JHU-Delivery-Robot/electrical/PMS/PMS/PMS.kicad_pcb

## KiCad design PMS/PMS/PMS.kicad_pcb (2022-04-30)

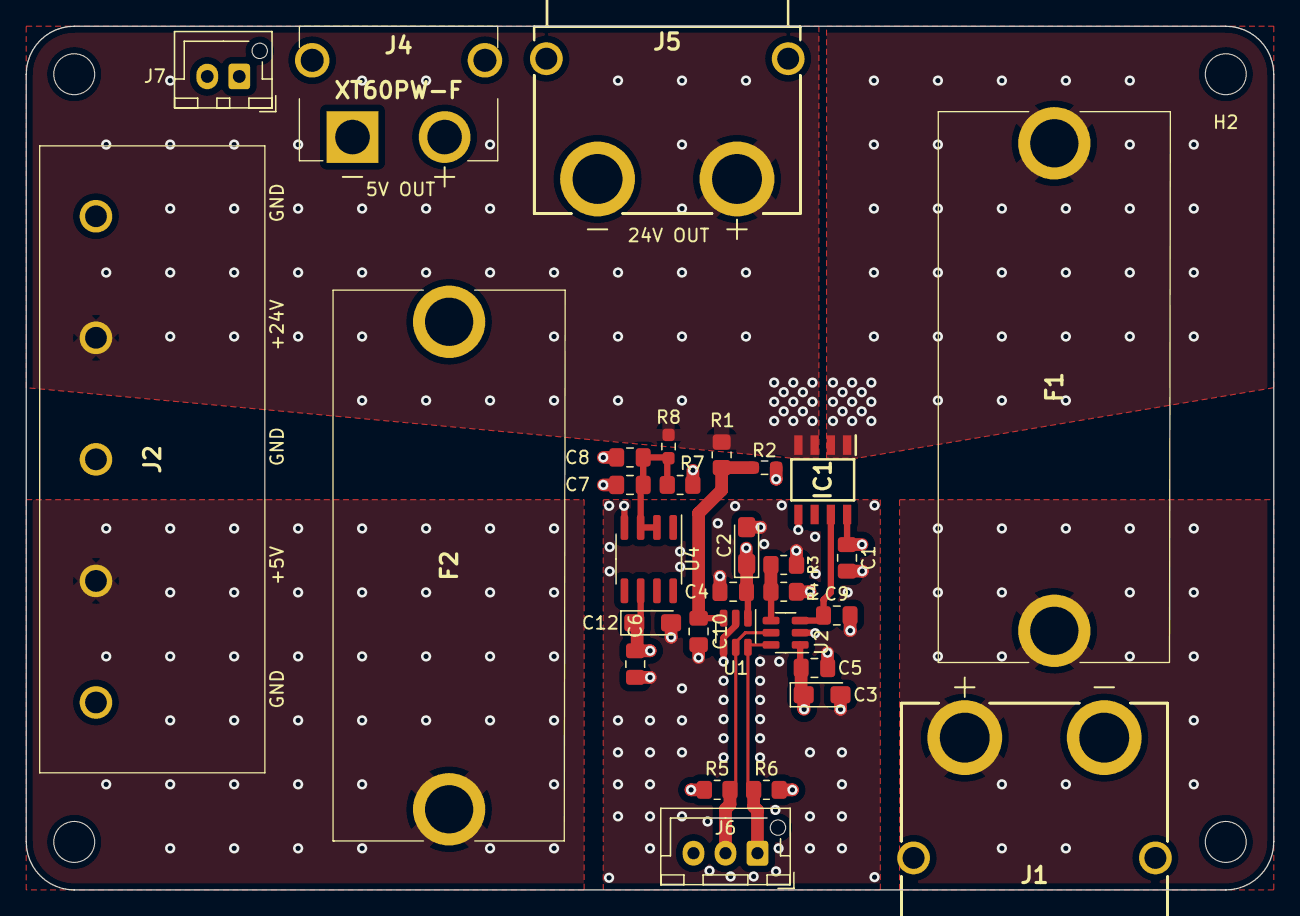
[picture p1: board PMS.kicad_pcb from above]

Board: 4 copper layers, 97.5 x 67.5 mm, 35 parts (0 on the bottom side), 13 nets.

Parts:
C1, C4, C5, C6, C7: .1uF; C_0805_2012Metric_Pad1.18x1.45mm_HandSolder
C2, C3: 4.7uF; CP_EIA-3216-18_Kemet-A_Pad1.58x1.35mm_HandSolder
C8: 10uF; C_0805_2012Metric_Pad1.18x1.45mm_HandSolder
C9, C10: 470 pF; C_0805_2012Metric_Pad1.18x1.45mm_HandSolder
C12: 1 uF; CP_EIA-3216-18_Kemet-A_Pad1.58x1.35mm_HandSolder
F1: 30A; 3576
F2: 7.5+ A; 3576
H1, H2, H3, H4: MountingHole; MountingHole_3.2mm_M3_ISO14580
IC1: TMCS1107A1BQDRQ1; SOIC127P600X175-8N
J1: XT90PW-M; XT90PWM
J2: OSTYK44105030
J4: XT60PW-F; XT60PWF
J5: XT90PW-F
J6: Conn_01x03_Male; JST_XH_B3B-XH-AM_1x03_P2.50mm_Vertical
J7: Conn_01x02_Male; JST_XH_B2B-XH-AM_1x02_P2.50mm_Vertical
R1: 100K; R_0805_2012Metric_Pad1.20x1.40mm_HandSolder
R2: 20K; R_0603_1608Metric_Pad0.98x0.95mm_HandSolder
R3, R4: 1M; R_0805_2012Metric_Pad1.20x1.40mm_HandSolder
R5, R6: 10K; R_0805_2012Metric_Pad1.20x1.40mm_HandSolder
R7: 1.5K; R_0805_2012Metric_Pad1.20x1.40mm_HandSolder
R8: 1.5K; R_0603_1608Metric_Pad0.98x0.95mm_HandSolder
U1, U2: ADC101C027CIMK; SOT-23-6
U4: REF195; SOIC-8_3.9x4.9mm_P1.27mm

Connections:
24V_OUT: IC1.3 (IN-_1), IC1.4 (IN-_2), J2.2, J5.2 (+), R1.1, R8.2
+5V: F2.2, J4.2 (+), J7.2
+5VA: C1.1, C2.1, C3.1, C4.1, C5.1, C6.1, C12.1, IC1.8 (VS), R4.2, R5.2, R6.2, U1.1 (V_{A}), U2.1 (V_{A}), U4.6 (Vout)
+5VP: F2.1, J2.4
+24V: F1.2, IC1.1 (IN+_1), IC1.2 (IN+_2)
+BATT: F1.1, J1.2 (+)
GND: C1.2, C2.2, C3.2, C4.2, C5.2, C6.2, C7.1, C8.2, C9.2, C10.2, C12.2, IC1.5 (GND), J1.1 (-), J2.1, J2.3, J2.5, J4.1 (-), J4.3, J4.4, J5.1 (-), J7.1, R2.2, R3.2, R7.1, U1.2 (GND), U1.4 (ADDR), U2.2 (GND), U4.4 (GND)
unnamed: C7.2, C8.1, R7.2, R8.1, U4.2 (Vin), U4.3 (~Sleep)
unnamed: C9.1, IC1.7 (VOUT), U2.3 (V_{IN})
unnamed: C10.1, R1.2, R2.1, U1.3 (V_{IN})
unnamed: R3.1, R4.1, U2.4 (ADDR)
SCL: J6.2, R5.1, U1.5 (SCL), U2.5 (SCL)
SDA: J6.1, R6.1, U1.6 (SDA), U2.6 (SDA)
