JHU-Delivery-Robot/electrical/IR-Breakout/IR-Breakout.kicad_pcb

## KiCad design IR-Breakout/IR-Breakout.kicad_pcb (2022-04-19)

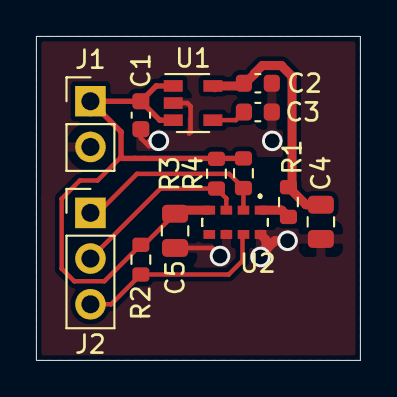
[picture p2: board IR-Breakout.kicad_pcb from above]

Board: 2 copper layers, 18.0 x 18.0 mm, 13 parts (0 on the bottom side), 8 nets.

Parts:
C1, C2: 1u; C_0603_1608Metric
C3: 0.1u; C_0603_1608Metric
C4: 4.7u; C_0805_2012Metric
C5: 10u; C_0805_2012Metric
J1: PWR; PinHeader_1x02_P2.54mm_Vertical
J2: I2C; PinHeader_1x03_P2.54mm_Vertical
R1: 22; R_0603_1608Metric
R2, R3, R4: 10K; R_0603_1608Metric
U1: LDK120M18R; SOT-23-5
U2: TMD37253M

Connections:
+1V8: C2.1, C4.1, R1.1, U1.5 (OUT)
+3V3: C1.1, C5.1, J1.1, R2.1, R3.1, R4.1, U1.1 (IN), U1.3 (EN), U2.4 (LEDA)
/INT: J2.3, R2.2, U2.7 (INT)
/SCL: J2.2, R3.2, U2.3 (SCL)
/SDA: J2.1, R4.2, U2.2 (SDA)
GND: C1.2, C2.2, C3.2, C4.2, C5.2, J1.2, U1.2 (GND), U2.6 (PGND), U2.8 (VSS)
unnamed: C3.1, U1.4 (BP)
unnamed: R1.2, U2.1 (VDD)
