JHU-Delivery-Robot/electrical/motor-controller/motor-controller.kicad_pcb

## KiCad design motor-controller/motor-controller.kicad_pcb (2021-01-12)

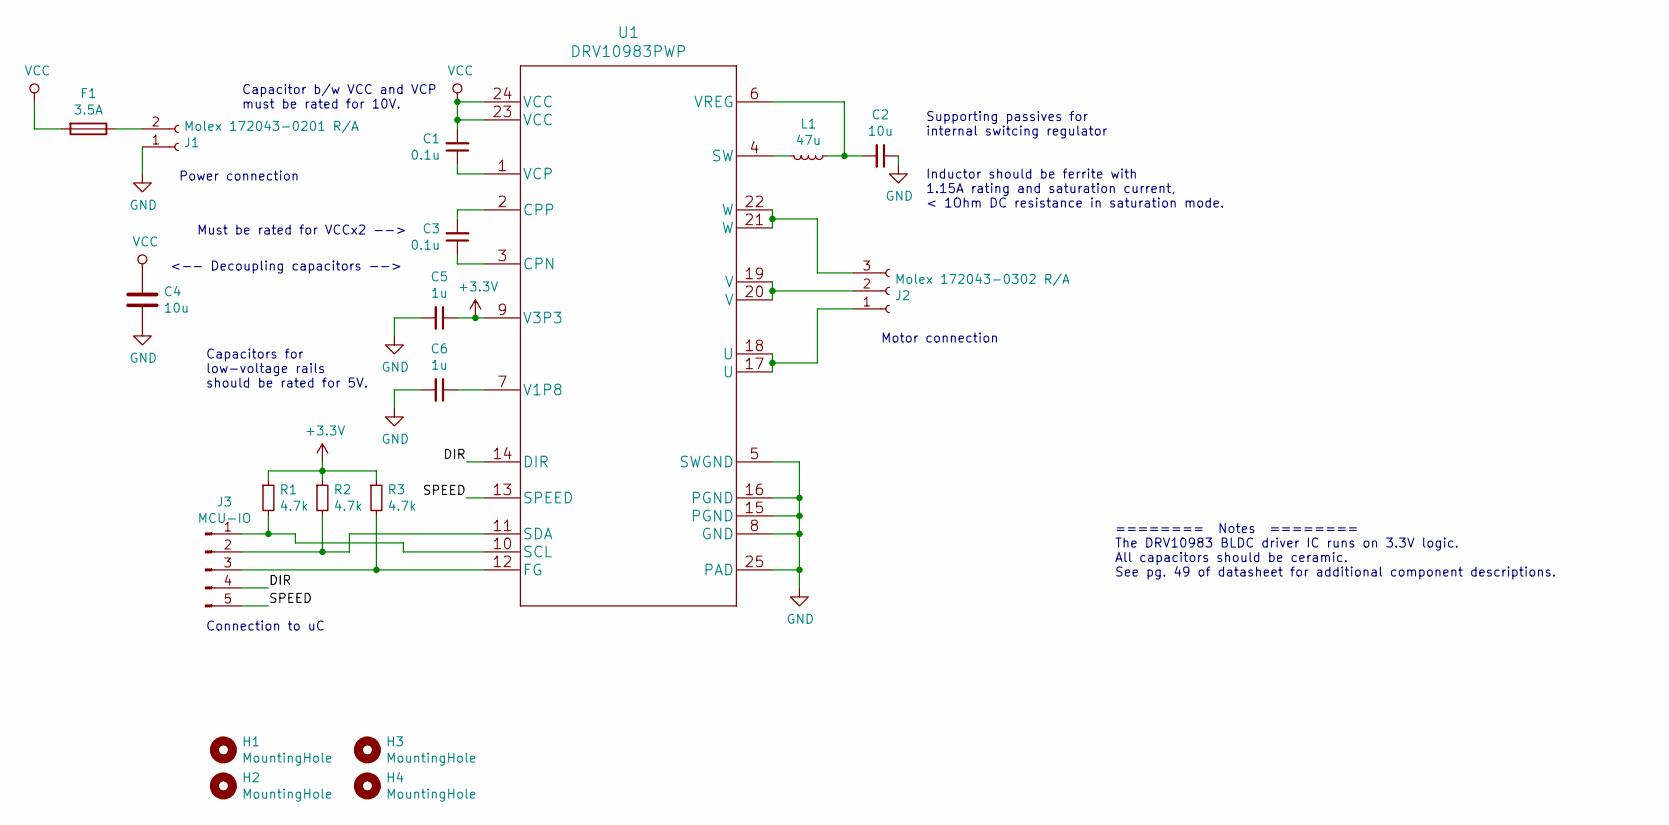
[picture p3: schematic motor-controller.sch, Brushless DC Motor Controller]

Parts:
C1, C3: 0.1u; C_0603_1608Metric
C2, C4: 10u; C_0603_1608Metric
C5, C6: 1u; C_0603_1608Metric
F1: 3.5A; littelfuse-01110505Z-5x15mm
H1, H2, H3, H4: MountingHole; MountingHole_3.2mm_M3
J1: Molex 172043-0201 R/A; CONN_1720430201_MOL
J2: Molex 172043-0302 R/A; 172043-0302_MOL
J3: MCU-IO; JST_XH_B05B-XH-AM_1x05_P2.50mm_Vertical
L1: 47u; L_Taiyo-Yuden_NR-60xx
R1, R2, R3: 4.7k; R_0603_1608Metric
U1: DRV10983PWP; PWP0024B

Connections:
+3V3: C5.1, R1.1, R2.1, R3.1, U1.9 (V3P3); also elsewhere on the board
/DIR: J3.4, U1.14 (DIR); also elsewhere on the board
/SPEED: J3.5, U1.13 (SPEED); also elsewhere on the board
GND: C2.1, C4.2, C5.2, C6.2, J1.1, U1.5 (SWGND), U1.8 (GND), U1.15 (PGND), U1.16 (PGND), U1.25 (PAD); also elsewhere on the board
unnamed 4: C1.1, U1.1 (VCP); also elsewhere on the board
unnamed 5: C2.2, L1.1, U1.6 (VREG); also elsewhere on the board
unnamed 6: C3.1, U1.3 (CPN); also elsewhere on the board
unnamed 7: C3.2, U1.2 (CPP); also elsewhere on the board
unnamed 8: C6.1, U1.7 (V1P8); also elsewhere on the board
unnamed: F1.1, J1.2
unnamed 10: J2.1, U1.17 (U), U1.18 (U); also elsewhere on the board
unnamed 11: J2.2, U1.19 (V), U1.20 (V); also elsewhere on the board
unnamed 12: J2.3, U1.21 (W), U1.22 (W); also elsewhere on the board
unnamed 13: J3.1, R1.2, U1.10 (SCL); also elsewhere on the board
unnamed 14: J3.2, R2.2, U1.11 (SDA); also elsewhere on the board
unnamed 15: J3.3, R3.2, U1.12 (FG); also elsewhere on the board
unnamed 16: L1.2, U1.4 (SW); also elsewhere on the board
VCC: C1.2, C4.1, F1.2, U1.23 (VCC), U1.24 (VCC); also elsewhere on the board

Notes on the sheet:
Motor connection
Power connection
<-- Decoupling capacitors -->
Supporting passives for internal switcing regulator
Connection to uC
Capacitor b/w VCC and VCP must be rated for 10V.
Capacitors for low-voltage rails should be rated for 5V.
Must be rated for VCCx2 -->
======== Notes ======== The DRV10983 BLDC driver IC runs on 3.3V logic. All capacitors should be ceramic. See pg. 49 of datasheet for additional component descriptions.
Inductor should be ferrite with 1.15A rating and saturation current, < 1Ohm DC resistance in saturation mode.

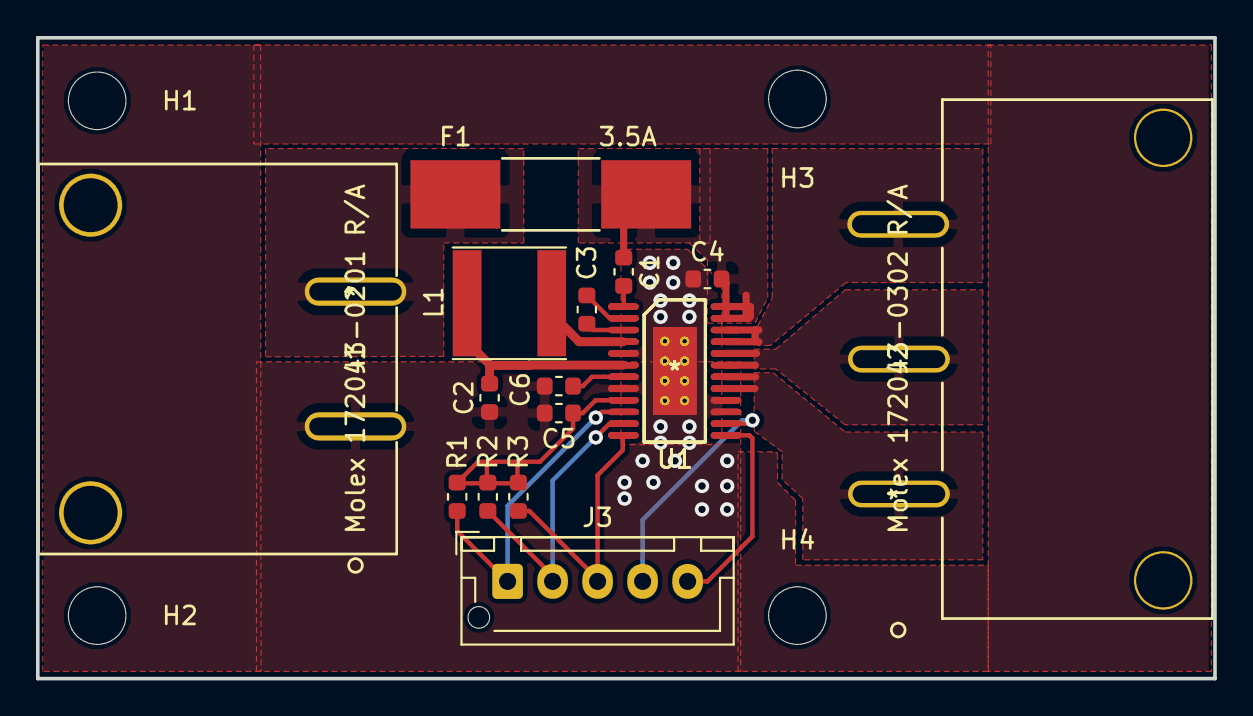
[picture p4: board motor-controller.kicad_pcb from above]

Board: 2 copper layers, 65.4 x 35.6 mm, 21 parts (0 on the bottom side), 18 nets.

Other parts of the board:
U1#2, U1#3: DRV10983PWP; PWP0024B

Their connections:
+3V3: U1#2.9, U1#3.9; also elsewhere on the board
/DIR: U1#2.14, U1#3.14; also elsewhere on the board
/SPEED: U1#2.13, U1#3.13; also elsewhere on the board
GND: U1#2.5, U1#2.8, U1#2.15, U1#2.16, U1#2.25, U1#3.5, U1#3.8, U1#3.15, U1#3.16, U1#3.25; also elsewhere on the board
unnamed 4: U1#2.1, U1#3.1; also elsewhere on the board
unnamed 5: U1#2.6, U1#3.6; also elsewhere on the board
unnamed 6: U1#2.3, U1#3.3; also elsewhere on the board
unnamed 7: U1#2.2, U1#3.2; also elsewhere on the board
unnamed 8: U1#2.7, U1#3.7; also elsewhere on the board
unnamed 10: U1#2.17, U1#2.18, U1#3.17, U1#3.18; also elsewhere on the board
unnamed 11: U1#2.19, U1#2.20, U1#3.19, U1#3.20; also elsewhere on the board
unnamed 12: U1#2.21, U1#2.22, U1#3.21, U1#3.22; also elsewhere on the board
unnamed 13: U1#2.10, U1#3.10; also elsewhere on the board
unnamed 14: U1#2.11, U1#3.11; also elsewhere on the board
unnamed 15: U1#2.12, U1#3.12; also elsewhere on the board
unnamed 16: U1#2.4, U1#3.4; also elsewhere on the board
VCC: U1#2.23, U1#2.24, U1#3.23, U1#3.24; also elsewhere on the board
