JHU-Delivery-Robot/electrical/(commit log)

2020-12-30 Added BLDC motorcontroller IC PCB
    [motor-controller.kicad_pcb, motor-controller.sch]
2020-12-30 Added ground planes, thermal vias
    [motor-controller.kicad_pcb]
2020-12-30 Added back top edge cut
    [motor-controller.kicad_pcb]
2021-01-12 Added fuse holder and modified position of mounting holes
    [motor-controller.kicad_pcb, motor-controller.sch]
2021-09-12 Add IR Breakout PCB
    Note: This PCB is designed to be fabricated on the PCB mill.
    [IR-Breakout.csv, IR-Breakout.kicad_pcb, IR-Breakout.sch]
2022-02-15 Adding PMS. Pending review
    [PMS.kicad_pcb, PMS.kicad_sch]
2022-02-15 several changes to satisfy ERC
    [PMS.kicad_sch]
2022-02-23 Updated PMS. Now includes option for LA12 with other fixes.
    [PMS.kicad_sch]
2022-02-24 annotated schematic
    [PMS.kicad_sch]
2022-02-25 added reverse polarity protection
    [PMS.kicad_sch]
2022-02-25 cleanup and now ERC compliant
    [PMS.kicad_sch]
2022-02-25 switched to the correct zener diode
    [PMS.kicad_sch]
2022-03-03 Associated footprints to components
    [PMS.kicad_sch]
2022-03-06 adding BOM PMS.csv
    [PMS.csv, PMS.kicad_pcb, PMS.kicad_sch]
2022-03-07 Layout complete.
    [PMS.kicad_pcb, PMS.kicad_sch]
2022-03-07 all traces now routed on the topmost layer
    [PMS.kicad_pcb]
2022-03-08 moved silkscreen
    [PMS.kicad_pcb]
2022-03-15 Changed regulator and updated layout. No longer includes LA12.
    [PMS.kicad_pcb]
2022-03-15 updates to satisfy DRC
    [PMS.kicad_pcb]
2022-03-16 changed solder jumper footprint and added silk labels for XT60 connectors
    [PMS.kicad_pcb, PMS.kicad_sch]
2022-03-18 changed to XT90s for 24V
    [PMS.kicad_pcb, PMS.kicad_sch]
2022-03-20 Changed to barrier strip for connection to Mean-Well. Interconnects cannot be erroneously connected
    [PMS.kicad_pcb, PMS.kicad_sch]
2022-03-23 Adding updated BOM
    [PMS.csv]
2022-04-11 updated PMS. Resistor values chosen for accurate current. ADC layouts altered to add via fence and reduce EMI. ADC input low-pass capacitors added.
    [PMS.kicad_pcb, PMS.kicad_sch]
2022-04-12 minor changes
    [PMS.kicad_pcb, PMS.kicad_sch]
2022-04-12 changed star ground
    [PMS.kicad_pcb]
2022-04-12 More changes to grounding
    [PMS.kicad_pcb]
2022-04-19 corrected values for pullups on SDA, SCL, and INT
    [IR-Breakout.kicad_pcb, IR-Breakout.kicad_sch]
2022-04-25 increased distance between planes. Improved top GND plane for analog portion of board. simplified some geometries. VIAS.
    [PMS.kicad_pcb, PMS.kicad_sch]
2022-04-27 HOLY MOLY! Adding many, many vias for thermals and for EMI. Fencing spacing was altered to max wavelength / 40.
    [PMS.kicad_pcb]
2022-04-30 adding updated measurements for PMS
    [PMS.kicad_pcb]
